sauce-an/tp2_pm/Hardware/Diagrams/TP2-seminar LCD FSM.drawio.png

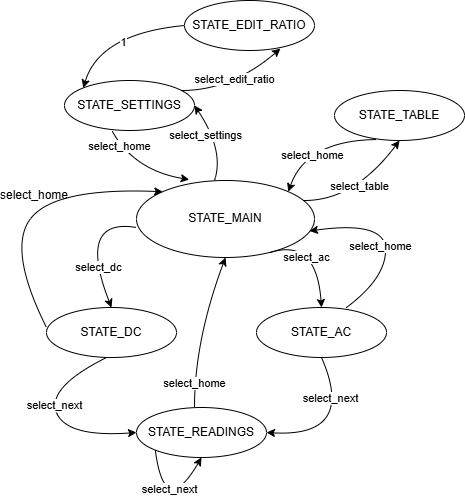
Hardware/Diagrams/TP2-seminar LCD FSM.drawio.png
