sauce-an/tp2_pm/Hardware/Schematics/ENGG3800 schemetic for seminar.pdf

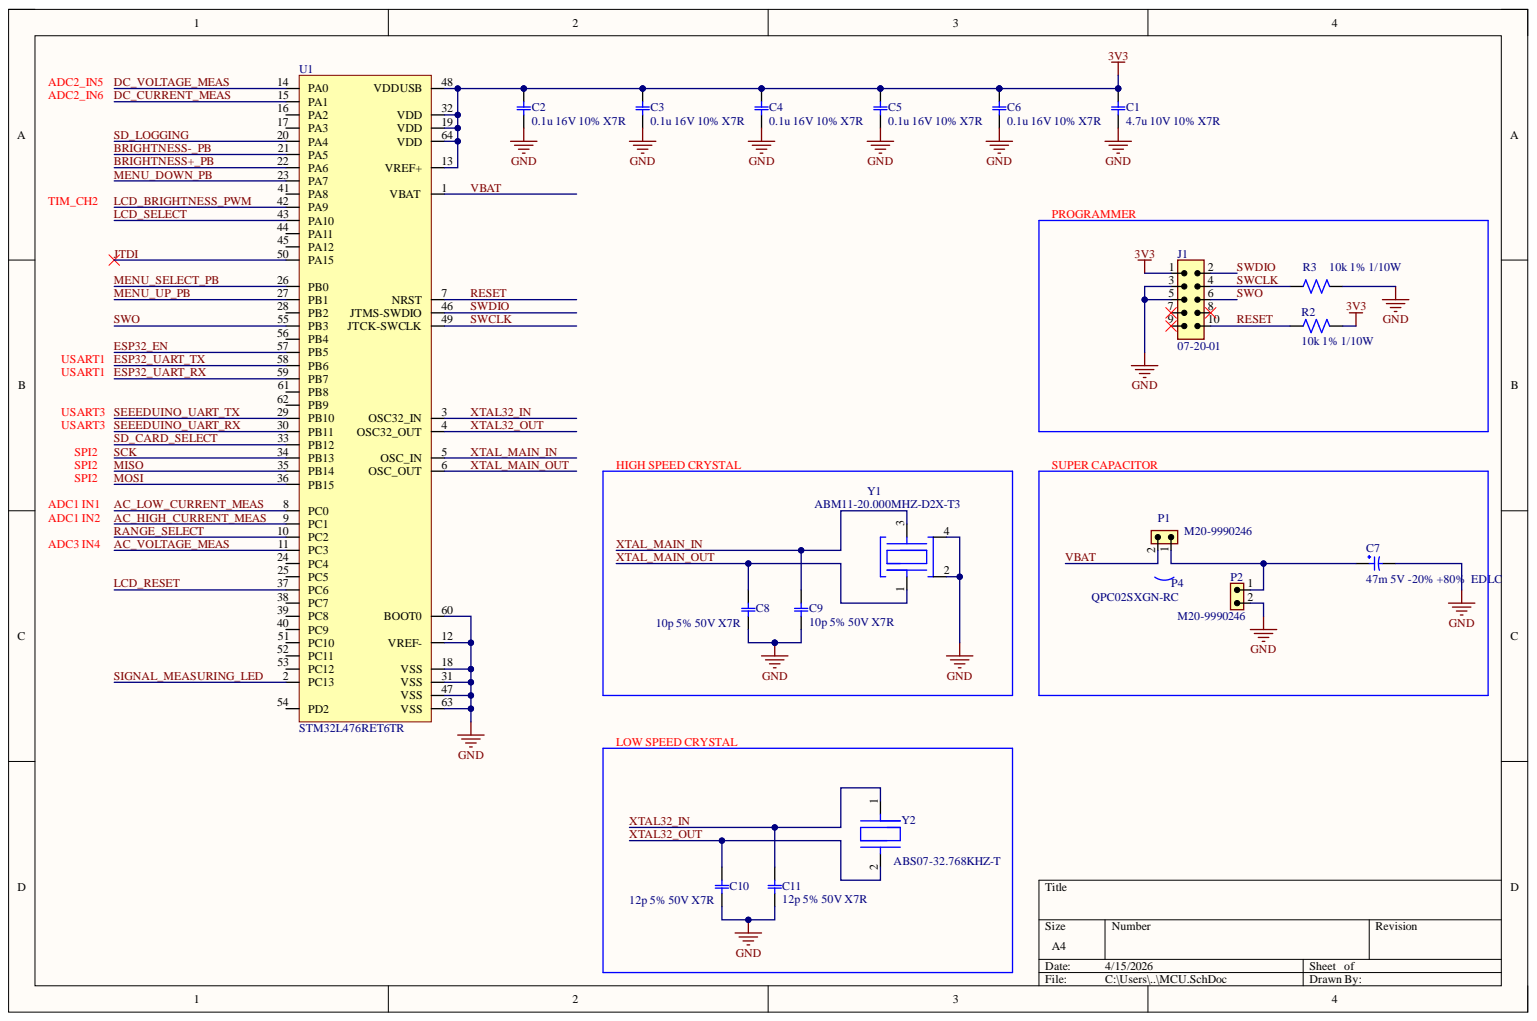
[picture p2: page 1]

1 9
6 4

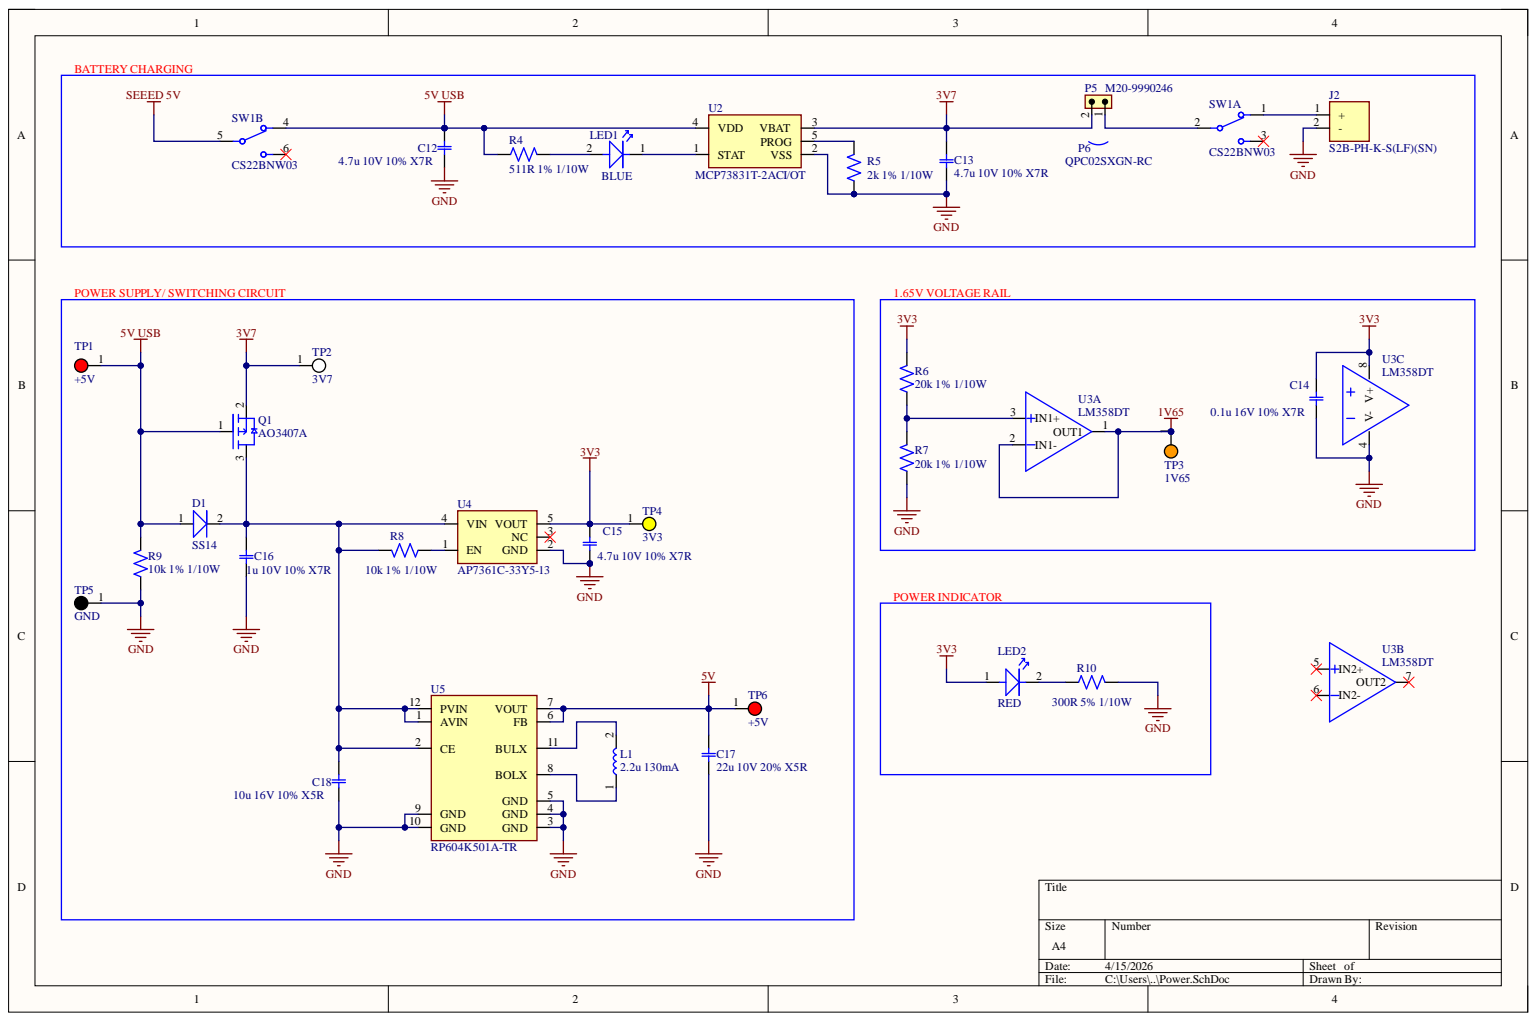
[picture p3: page 2]

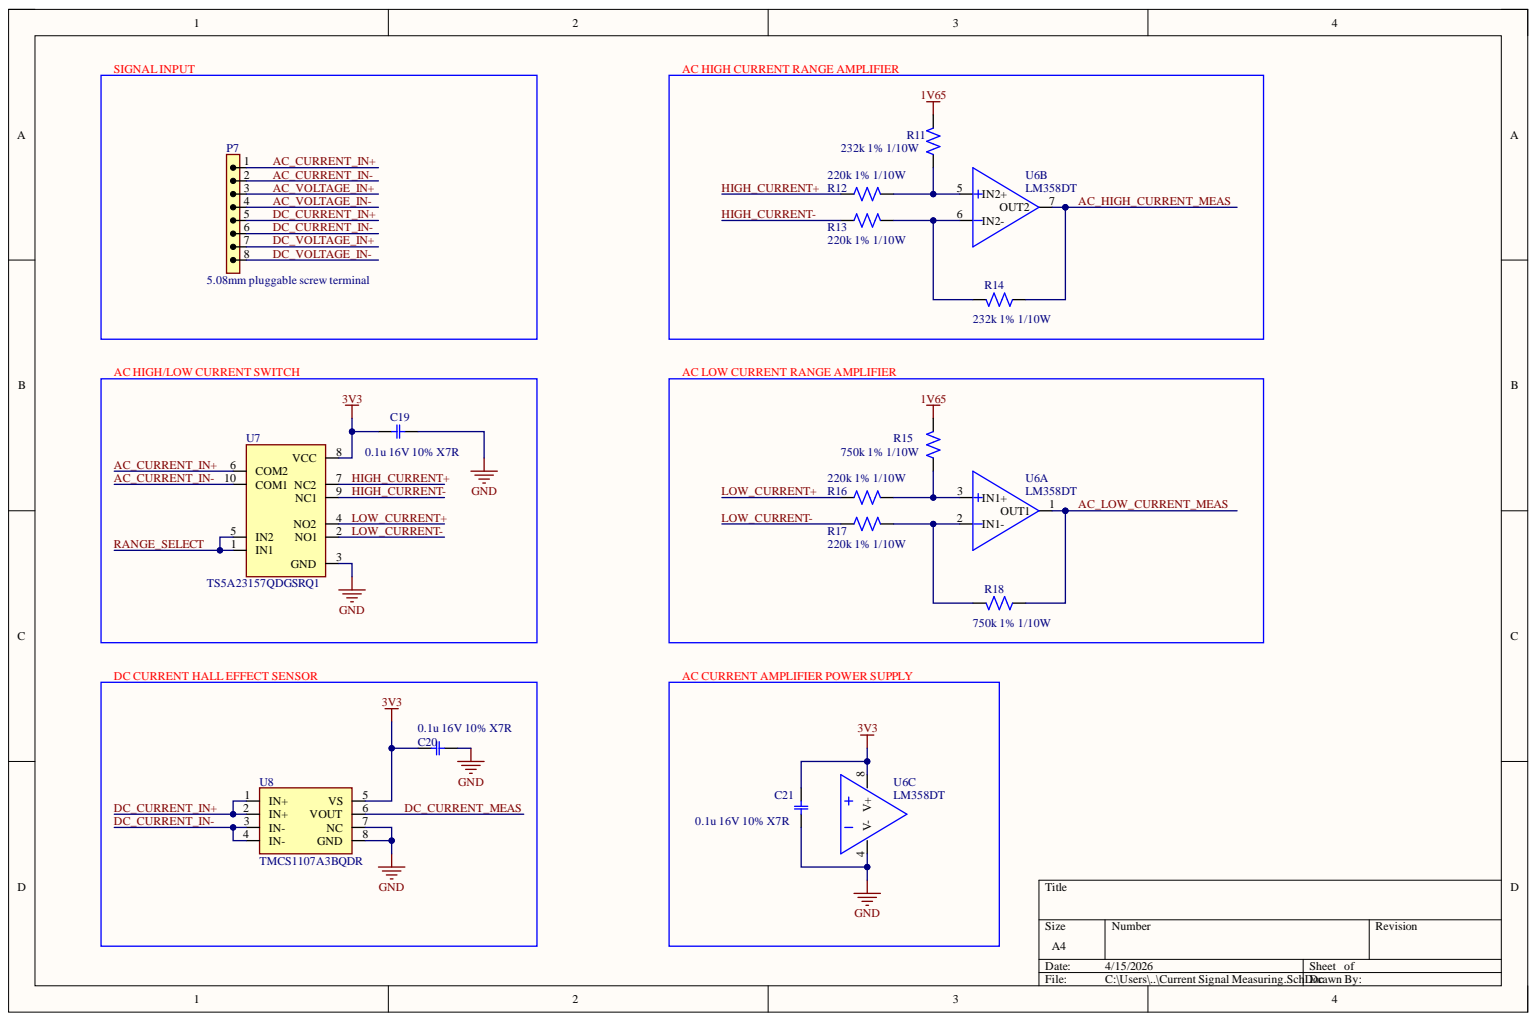
[picture p4: page 3]

AC HIGH CURRENT RANGE AMPLIFIER

AC HIGH/LOW CURRENT SWITCH

AC LOW CURRENT RANGE AMPLIFIER

DC CURRENT HALL EFFECT SENSOR

AC CURRENT AMPLIFIER POWER SUPPLY

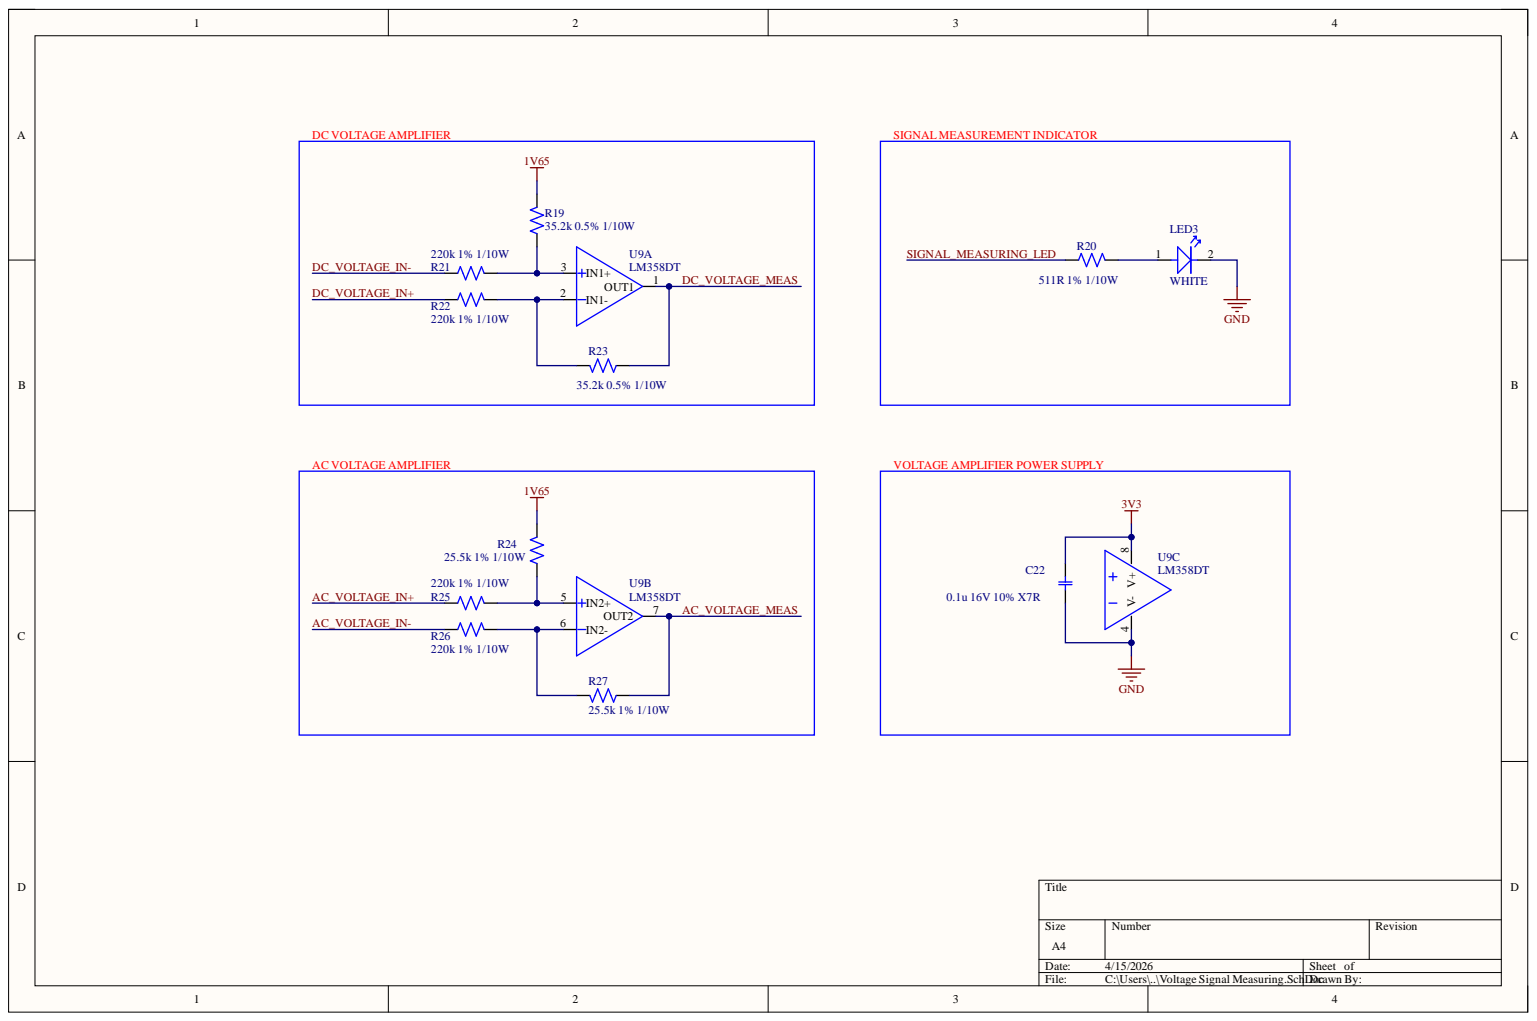
[picture p5: page 4]

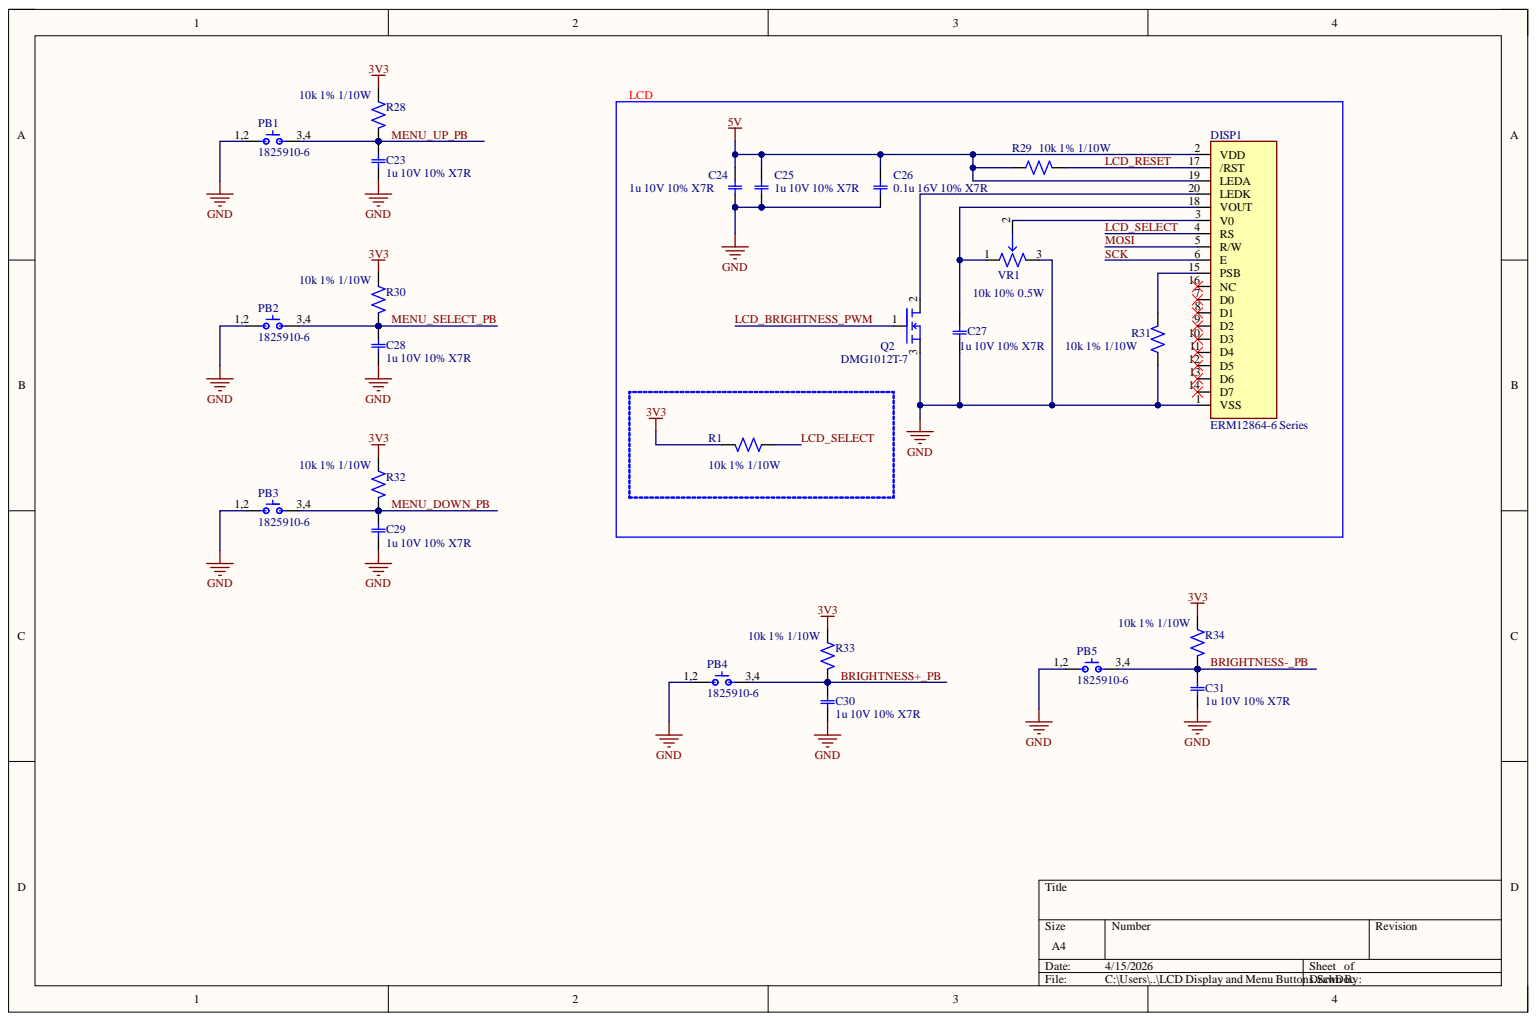
[picture p6: page 5]

1 u 1 0 V 1 0 % X 7 R | 0.1 u 1 6 V 1 0 % X | _RESE T 1 7

LCD _SE L E C T 4 3

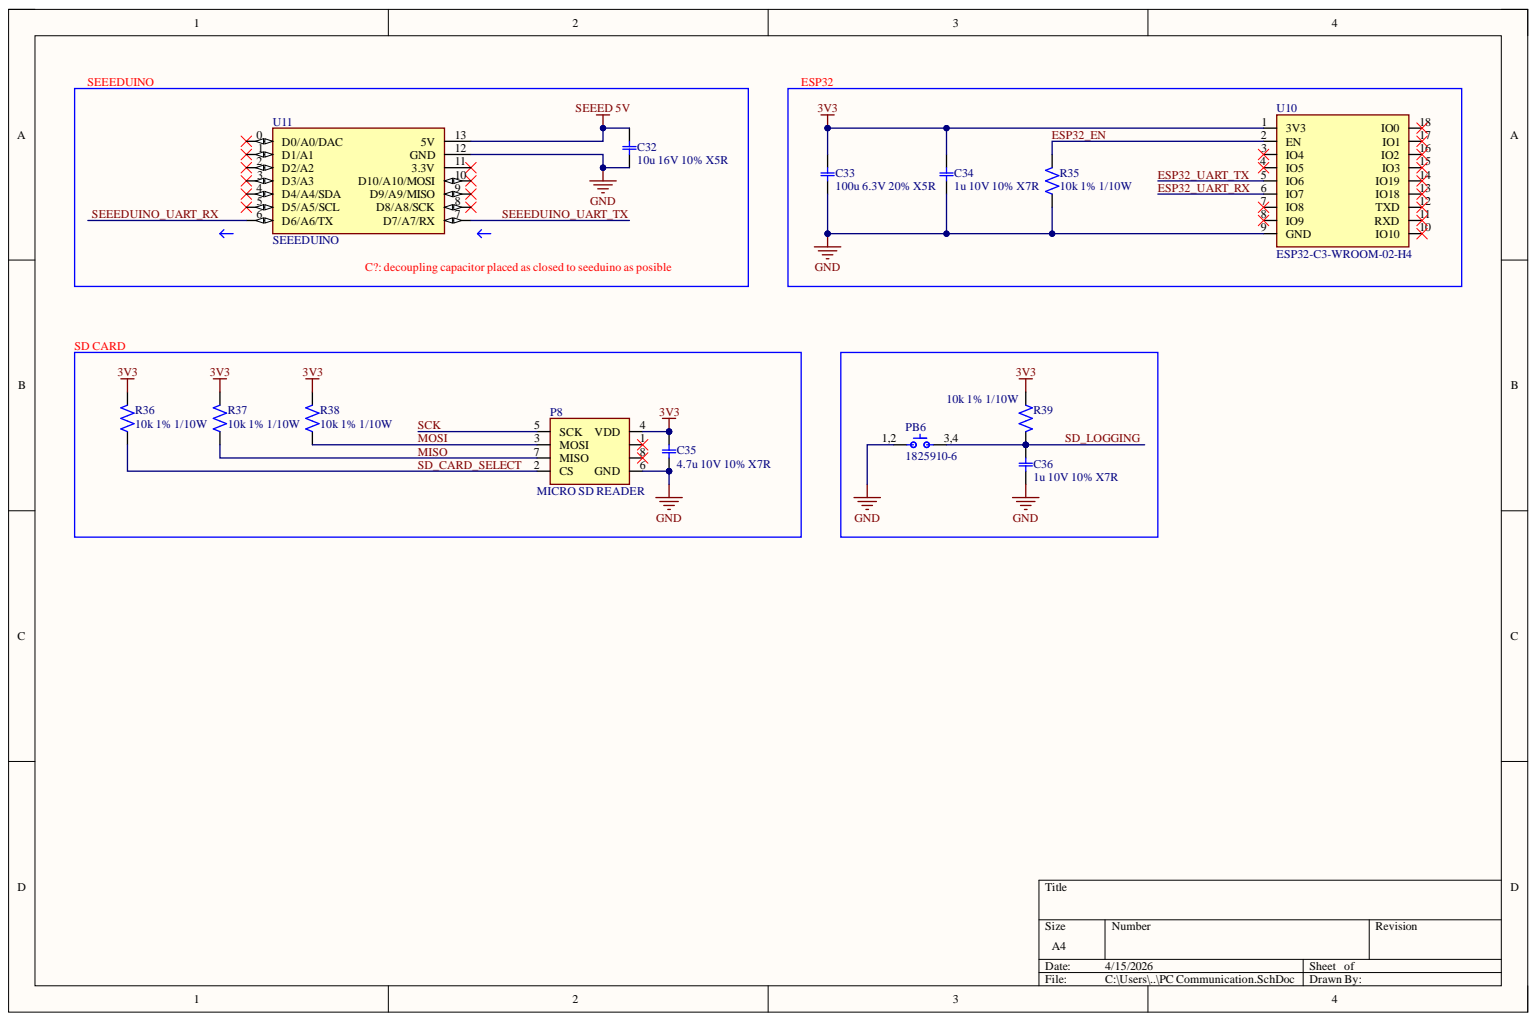
[picture p7: page 6]

C?: decoupling capacitor placed as closed to seeduino as posible

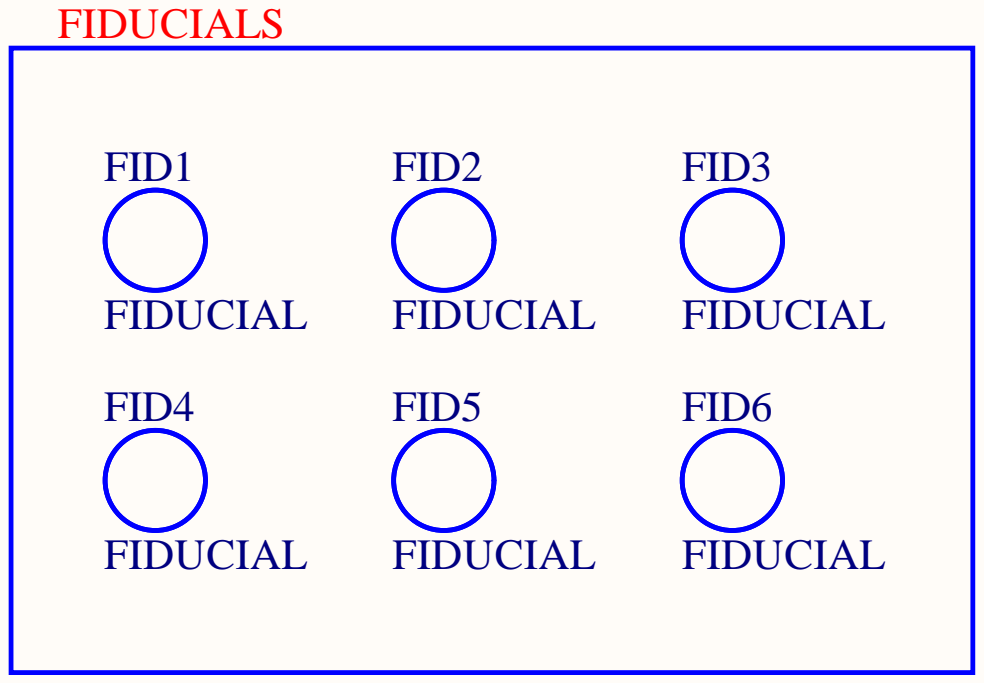
[picture p8: page 7]

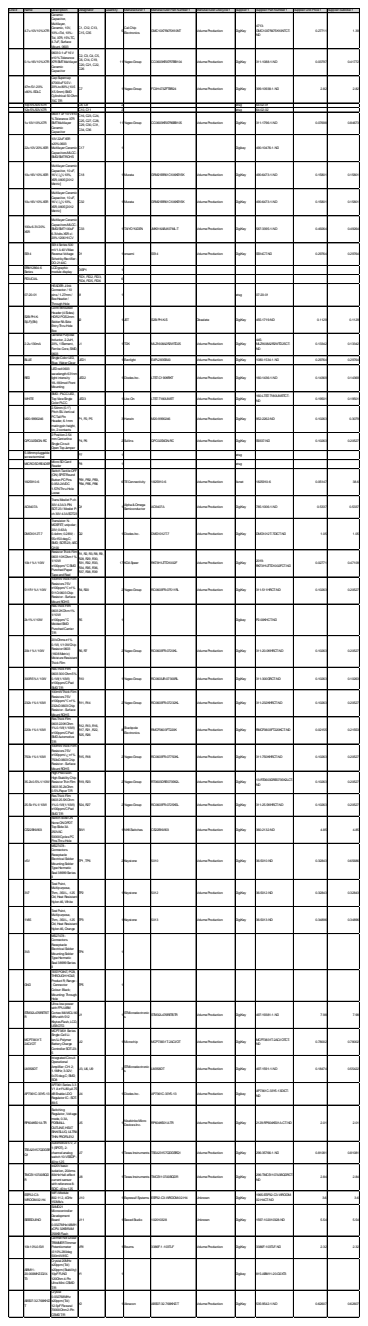
[picture p9: page 8]

0.1u16V10%X7R | 06030.1uF16V ±10%Tolerance X7RSMTMultilayer Ceramic Capacitor | C2, C3, C4, C5, C6, C14, C19, C20, C21, C22, C26 | 11 YageoGroup | CC0603KRX7R7BB104 | VolumeProduction | DigiKey | 311-1088-1-ND | 0.03797 | 0.41772

47m5V-20% +80% EDLC | CapSupercap 47000uF5.5V-20%to80%(10.5 X5.5mm) SMD Cylindrical 50Ohm 70CT/R | C7 | 1 YageoGroup | FC0H473ZFTBR24 | VolumeProduction | DigiKey | 399-10938-1-ND | 2.82 | 2.82

12p5%50VX7R 10p5%50VX7R 1u10V10%X7R | 06031uF10V±10 %ToleranceX7R SMTMultilayer Ceramic Capacitor | C10, C11 C8, C9 C16, C23, C24, C25, C27, C28, C29, C30, C31, C34, C36 | 2 2 11 YageoGroup | CC0603KRX7R6BB105 | VolumeProduction | etsg etsg DigiKey | 64-02-02 64-02-01 311-1796-1-ND | 0.07698 | 0.84673

22u10V20%X5R | 10V22uFX5R ±20%0603 Multilayer Ceramic CapacitorsMLCC-SMD/SMTROHS | C17 | 1 | | | Digikey | 490-10476-1-ND

10u16V10%X5R | Multilayer Ceramic Capacitor, 10uF, 16V, ï¿½10%, X5R, 0805[2012 Metric] | C18 | 1 Murata | GRM21BR61C106KE15K | VolumeProduction | DigiKey | 490-6473-1-ND | 0.15801 | 0.15801

10u16V10%X5R | Multilayer Ceramic Capacitor, 10uF, 16V, ï¿½10%, X5R, 0805[2012 Metric] | C32 | 1 Murata | GRM21BR61C106KE15K | VolumeProduction | DigiKey | 490-6473-1-ND | 0.15801 | 0.15801

100u6.3V20% X5R | Multilayer Ceramic CapacitorsMLCC-SMD/SMT100uF 6.3VoltsX5R+/-20%1206HICV | C33 | 1 TAIYOYUDEN | JMK316ABJ107ML-T | VolumeProduction | DigiKey | 587-3395-1-ND | 0.49264 | 0.49264

SS14 | SS14Series500 mV1A40VMax ReverseVoltage SchottkyRectifier -DO-214AC | D1 | 1 onsemi | SS14 | VolumeProduction | DigiKey | SS14CT-ND | 0.29764 | 0.29764

ERM12864-6 Series | LCDgraphic module display | DISP1 | 1

FIDUCIAL | | FID1, FID2, FID3, FID4, FID5, FID6 | 6

07-20-01 | HEADER: J-link Connector / 10 pins / 1.27mm/ BoxHeader / ThroughHole | J1 | 1 | | | etsg | 07-20-01

S2B-PH-K-S(LF)(SN) | ConnShrouded Header (4Sides) HDR2POS2mm Solder RASide EntryThru-Hole Box | J2 | 1 JST | S2B-PH-K-S | Obsolete | DigiKey | 455-1719-ND | 0.1129 | 0.1129

2.2u130mA | General Purpose Inductor, 2.2uH, 20%, 1Element, Ferrite-Core, SMD, 0603 | L1 | 1 TDK | MLZ1608A2R2WTD25 | VolumeProduction | DigiKey | 445-MLZ1608A2R2WTD25CT-ND | 0.13342 | 0.13342

BLUE | Single Color LED, Blue, Water Clear | LED1 | 1 Everlight | EAPL2835BA3 | VolumeProduction | DigiKey | 1080-1534-1-ND | 0.29764 | 0.29764

RED | LEDred0603 wavelength631nm light intensity 18~180mcd Front Mounting | LED2 | 1 Diodes Inc. | LTST-C190KRKT | VolumeProduction | DigiKey | 160-1436-1-ND | 0.14369 | 0.14369

WHITE | SMD- PLCCLED, TopViewSingle Color PLCC | LED3 | 1 Lite-On | LTST-T180UWET | VolumeProduction | DigiKey | 160-LTST-T180UWETCT-ND | 0.19501 | 0.19501

M20-9990246 | 2.54mm(0.1") PitchSILVertical PCTail Pin Header, 6.1mm matingpin height, tin, 2contacts | P1, P2, P5 | 3 Harwin | M20-9990246 | VolumeProduction | DigiKey | 952-2262-ND | 0.10263 | 0.3079

QPC02SXGN-RC | 2Position2.54 mmCenterline Single Circuit OpenTopJumper | P4, P6 | 2 Sullins | QPC02SXGN-RC | VolumeProduction | DigiKey | S9337-ND | 0.10263 | 0.20527

5.08mmpluggable screwterminal | | P7 | 1 | | | etsg

MICROSDREADER MicroSDCard | Reader | P8 | 1 | | | etsg

1825910-6 | Switch Tactile OFF (ON) SPSTRound ButtonPCPins 0.05A24VDC 1.57NThru-Hole Loose | PB1, PB2, PB3, PB4, PB5, PB6 | 6 TEConnectivity | 1825910-6 | VolumeProduction | Avnet | 1825910-6 | 0.05147 | 38.6

AO3407A | TransMosfet P-ch 30V4.3A3-PIN SOT-23/ Mosfet P-ch 30V4.3ASOT23 | Q1 | 1 Alpha&Omega Semiconductor | AO3407A | VolumeProduction | DigiKey | 785-1006-1-ND | 0.5337 | 0.5337

DMG1012T-7 | Transistor: N-MOSFET; unipolar; 20V; 0.63A; 0.4ohm; 0.28W; -55+150deg.C; SMD; SOT523; AEC-Q100 | Q2 | 1 Diodes Inc. | DMG1012T-7 | VolumeProduction | DigiKey | DMG1012T-7DICT-ND | 1.05 | 1.05

10k1%1/10W | Resistor Thick Film 060310KOhm1% 1/10W ±100ppm/°CSMD PunchedPaper TapeandReel | R1, R2, R3, R8, R9, R28, R29, R30, R31, R32, R33, R34, R35, R36, R37, R38, R39 | 17 KOASpeer | RK73H1JTTD1002F | VolumeProduction | DigiKey | 2019-RK73H1JTTD1002FCT-ND | 0.02771 | 0.47109

511R1%1/10W | 100mWThick Film Resistors75V ±100ppm/℃ ±1% 511Ω0603Chip Resistor - Surface Mount ROHS | R4, R20 | 2 YageoGroup | RC0603FR-07511RL | VolumeProduction | DigiKey | 311-511HRCT-ND | 0.10263 | 0.20527

2k1%1/10W | ResThick Film 06032KOhm1% 1/10W ±100ppm/°C MoldedSMD PunchedCarrier T/R | R5 | 1 | | | Digikey | P2.00KHCT-ND

20k1%1/10W | 20kOhms±1% 0.1W, 1/10WChip Resistor 0603 (1608Metric) MoistureResistant Thick Film | R6, R7 | 2 YageoGroup | RC0603FR-0720KL | VolumeProduction | DigiKey | 311-20.0KHRCT-ND | 0.10263 | 0.20527

300R5%1/10W | ResThick Film 0603300Ohm5% 0.1W(1/10W) ±100ppm/CPad SMDT/R | R10 | 1 YageoGroup | RC0603JR-07300RL | VolumeProduction | DigiKey | 311-300GRCT-ND | 0.10263 | 0.10263

232k1%1/10W | 100mWThick Film Resistors75V ±100ppm/℃ ±1% 232kΩ0603Chip Resistor - Surface Mount ROHS | R11, R14 | 2 YageoGroup | RC0603FR-07232KL | VolumeProduction | DigiKey | 311-232KHRCT-ND | 0.10263 | 0.20527

220k1%1/10W | ResThick Film 0603220KOhm 1%0.1W(1/10W) ±100ppm/CPad SMDAutomotive T/R | R12, R13, R16, R17, R21, R22, R25, R26 | 8 Stackpole Electronics | RMCF0603FT220K | VolumeProduction | DigiKey | RMCF0603FT220KCT-ND | 0.02155 | 0.21553

750k1%1/10W | 100mWThick Film Resistors75V ±100ppm/℃ ±1% 750kΩ0603Chip Resistor - Surface Mount ROHS | R15, R18 | 2 YageoGroup | RC0603FR-07750KL | VolumeProduction | DigiKey | 311-750KHRCT-ND | 0.10263 | 0.20527

35.2k0.5%1/10W | HighPrecision-HighStabilityChip Resistor Thin Film 060335.2kOhm 0.5%Paper T/R | R19, R23 | 2 YageoGroup | RT0603DRE0735K2L | VolumeProduction | DigiKey | 13-RT0603DRE0735K2LCT-ND | 0.10263 | 0.20527

25.5k1%1/10W | ResThick Film 060325.5KOhm 1%0.1W(1/10W) ±100ppm/CPad SMDT/R | R24, R27 | 2 YageoGroup | RC0603FR-0725K5L | VolumeProduction | DigiKey | 311-25.5KHRCT-ND | 0.10263 | 0.20527

CS22BNW03 | SwitchSlideON NoneONDPDT TopSlide3A 250VAC 50000CyclesPC PinsThru-Hole | SW1 | 1 NKKSwitches | CS22BNW03 | VolumeProduction | DigiKey | 360-2132-ND | 4.85 | 4.85

+5V | MS27478-Connectors Receptacle Electrical Solder MountingSolder TypeHermetic Seal 38999Series II | TP1, TP6 | 2 Keystone | 5010 | VolumeProduction | DigiKey | 36-5010-ND | 0.32843 | 0.65686

3V7 | Test Point, Multipurpose, Thm, .350L, .125 Od, Heat Resistant Nylon46, White | TP2 | 1 Keystone | 5012 | VolumeProduction | DigiKey | 36-5012-ND | 0.32843 | 0.32843

1V65 | Test Point, Multipurpose, Thm, .350L, .125 Od, Heat Resistant Nylon46, Orange | TP3 | 1 Keystone | 5013 | VolumeProduction | DigiKey | 36-5013-ND | 0.34896 | 0.34896

3V3 | MS27478-Connectors Receptacle Electrical Solder MountingSolder TypeHermetic Seal 38999Series II | TP4 | 1

GND | TESTPOINT, PCB, THROUGHHOLE; Product R; Range: -; Connector Colour: Black; Mounting: Through Hole | TP5 | 1

STM32L476RET6T R | Ultra-low-power withFPUARM Cortex-M4MCU80 MHzwith512 KbytesFlash, LCD, USBOTG | U1 | 1 STMicroelectronic s | STM32L476RET6TR | VolumeProduction | DigiKey | 497-19381-1-ND | 7.98 | 7.98

MCP73831T-2ACI/OT | MCP73831Series Single-Cell Li-Ion/Li-Polymer BatteryCharge Controller SOT-23-5 | U2 | 1 Microchip | MCP73831T-2ACI/OT | VolumeProduction | DigiKey | MCP73831T-2ACI/OTCT-ND | 0.78002 | 0.78002

LM358DT | IntegratedCircuit Operational Amplifier; CH: 2; 1.1MHz; 3-32V; 0+70deg.C; SMD; SO8 | U3, U6, U9 | 3 STMicroelectronic s | LM358DT | VolumeProduction | DigiKey | 497-1591-1-ND | 0.18474 | 0.55422

AP7361C-33Y5-13 | AP7361Series3.3 V1A±1%80µA75 dBEnable LDO Regulator IC- SOT-89-5 | U4 | 1 Diodes Inc. | AP7361C-33Y5-13 | VolumeProduction | Digikey | AP7361C-33Y5-13DICT-ND

RP604K501A-TR | Switching Regulator, Voltage-mode, 0.3A, PDSMALL OUTLINE, HEAT SINK/SLUG, ULTRA THINPROFILE12 | U5 | 1 NisshinboMicro Devices Inc. | RP604K501A-TR | VolumeProduction | DigiKey | 2129-RP604K501A-CT-ND | 2.01 | 2.01

TS5A23157QDGSR Q1 | Automotive5-V, 2: 1(SPDT), 2-channel analog switch 10-VSSOP-40to125 | U7 | 1 Texas Instruments | TS5A23157QDGSRQ1 | VolumeProduction | DigiKey | 296-35766-1-ND | 0.81081 | 0.81081

TMCS1107A3BQD R | ±420Vbasic isolation, 20Arms 80kHzHall-effect current sensor withreference 8-SOIC-40to125 | U8 | 1 Texas Instruments | TMCS1107A3BQDR | VolumeProduction | DigiKey | 296-TMCS1107A3BQDRCT-ND | 2.84 | 2.84

ESP32-C3-WROOM-02-H4 | WiFi-Module 802.112, 4GHz 150Mb/s | U10 | 1 Espressif Systems | ESP32-C3-WROOM-02-H4 | Unknown | DigiKey | 1965-ESP32-C3-WROOM-02-H4CT-ND | 3.6 | | 3.6

SEEEDUINO | SAMD21 Microcontroller Development Board 0.0327MHz/48MH zCPU32KBRAM 256KBFlash | U11 | 1 SeeedStudio | 102010328 | Unknown | DigiKey | 1597-102010328-ND | 5.54 | 5.54

10k10%0.5W | Cermet Not Linear TRIMMERTrimmer Potentiometer 卤10%280deg 500mW85C | VR1 | 1 Bourns | 3386F-1-103TLF | VolumeProduction | DigiKey | 3386F-103TLF-ND | 2.32 | 2.32

ABM11-20.000MHZ-D2X-T3 | Crystal 20MHz ±20ppm(Tol) ±20ppm(Stability) 10pFFUND 120Ohm4-Pin UltraMini-CSMD T/R | Y1 | 1 | | | Digikey | 815-ABM11-20-D2XT3

ABS07-32.768KHZ-T | Crystal 0.032768MHz ±20ppm(Tol) 12.5pFFlexural 70000Ohm2-Pin CSMDT/R | Y2 | 1 Abracon | ABS07-32.768KHZ-T | VolumeProduction | DigiKey | 535-9542-1-ND | 0.62607 | 0.62607
