sauce-an/tp2_pm/Hardware/Schematics/ENGG3800_PCB_V2_schemetic.pdf

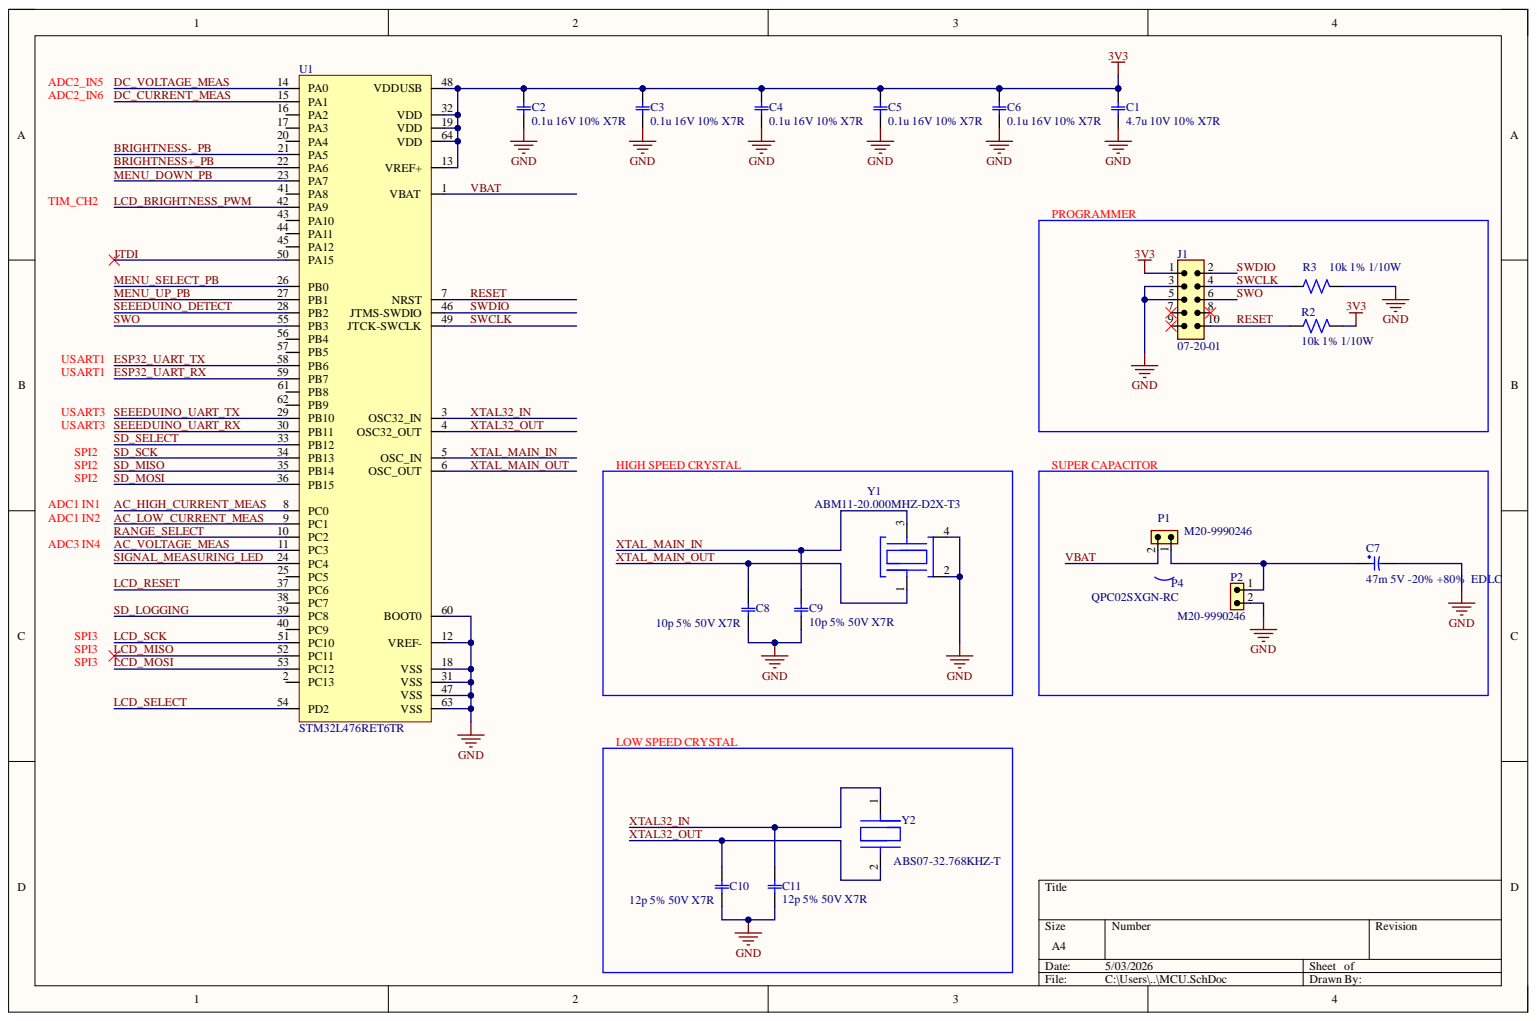
[picture p10: page 1]

1 9
6 4

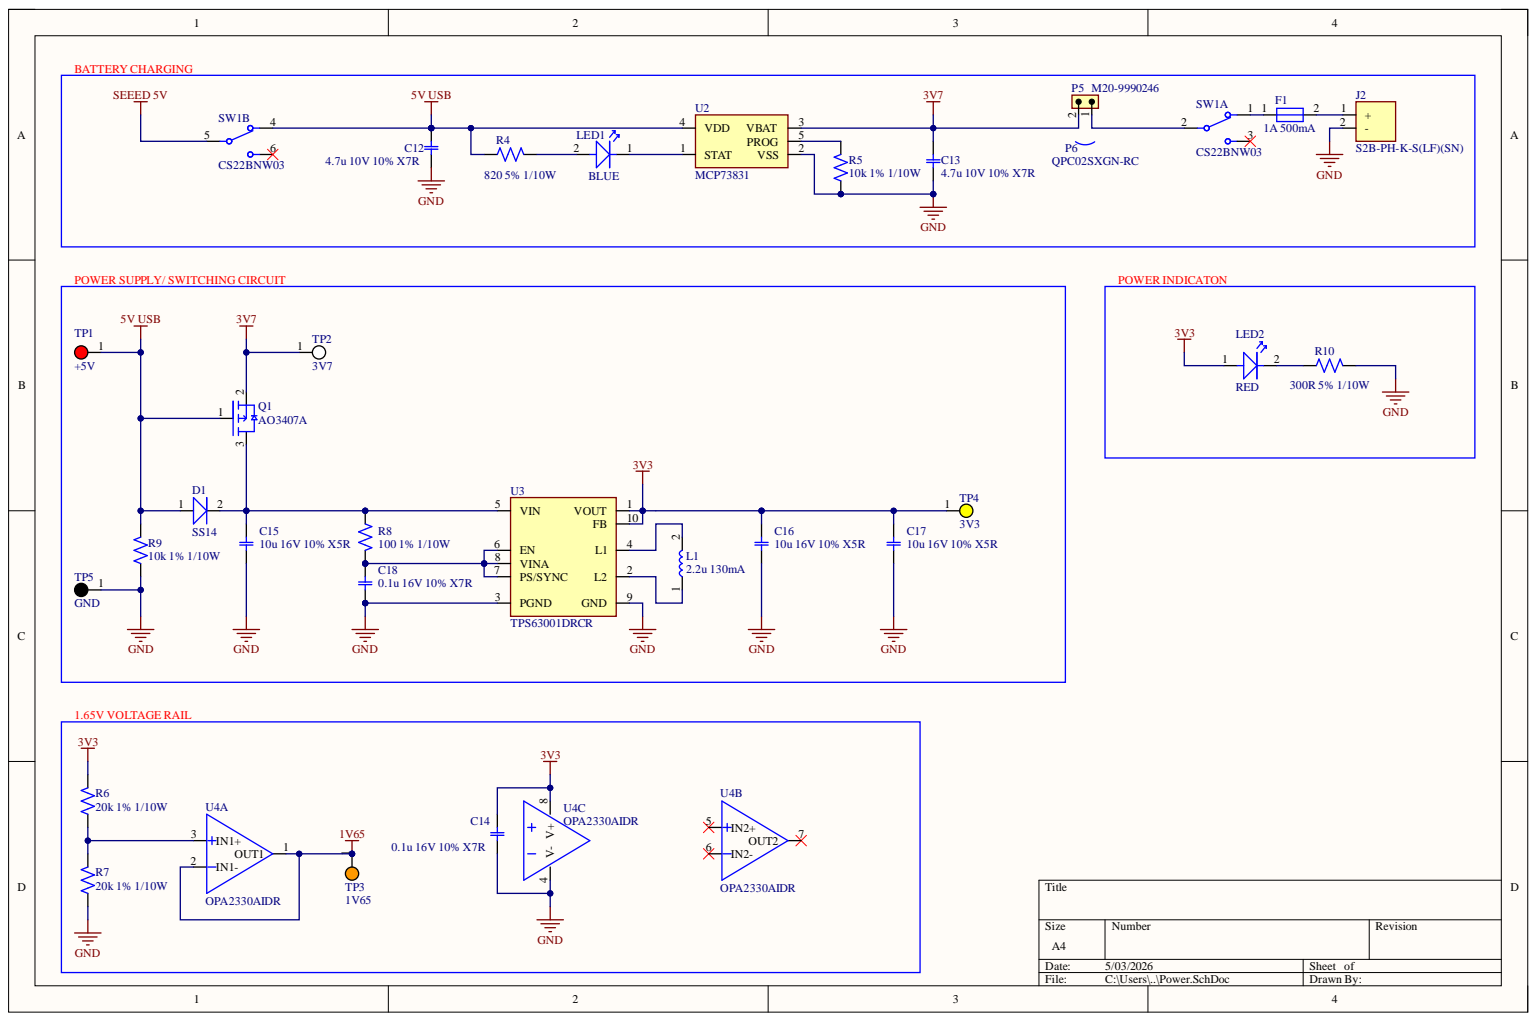
[picture p11: page 2]

POWER SUPPLY/ SWITCHING CIRCUIT

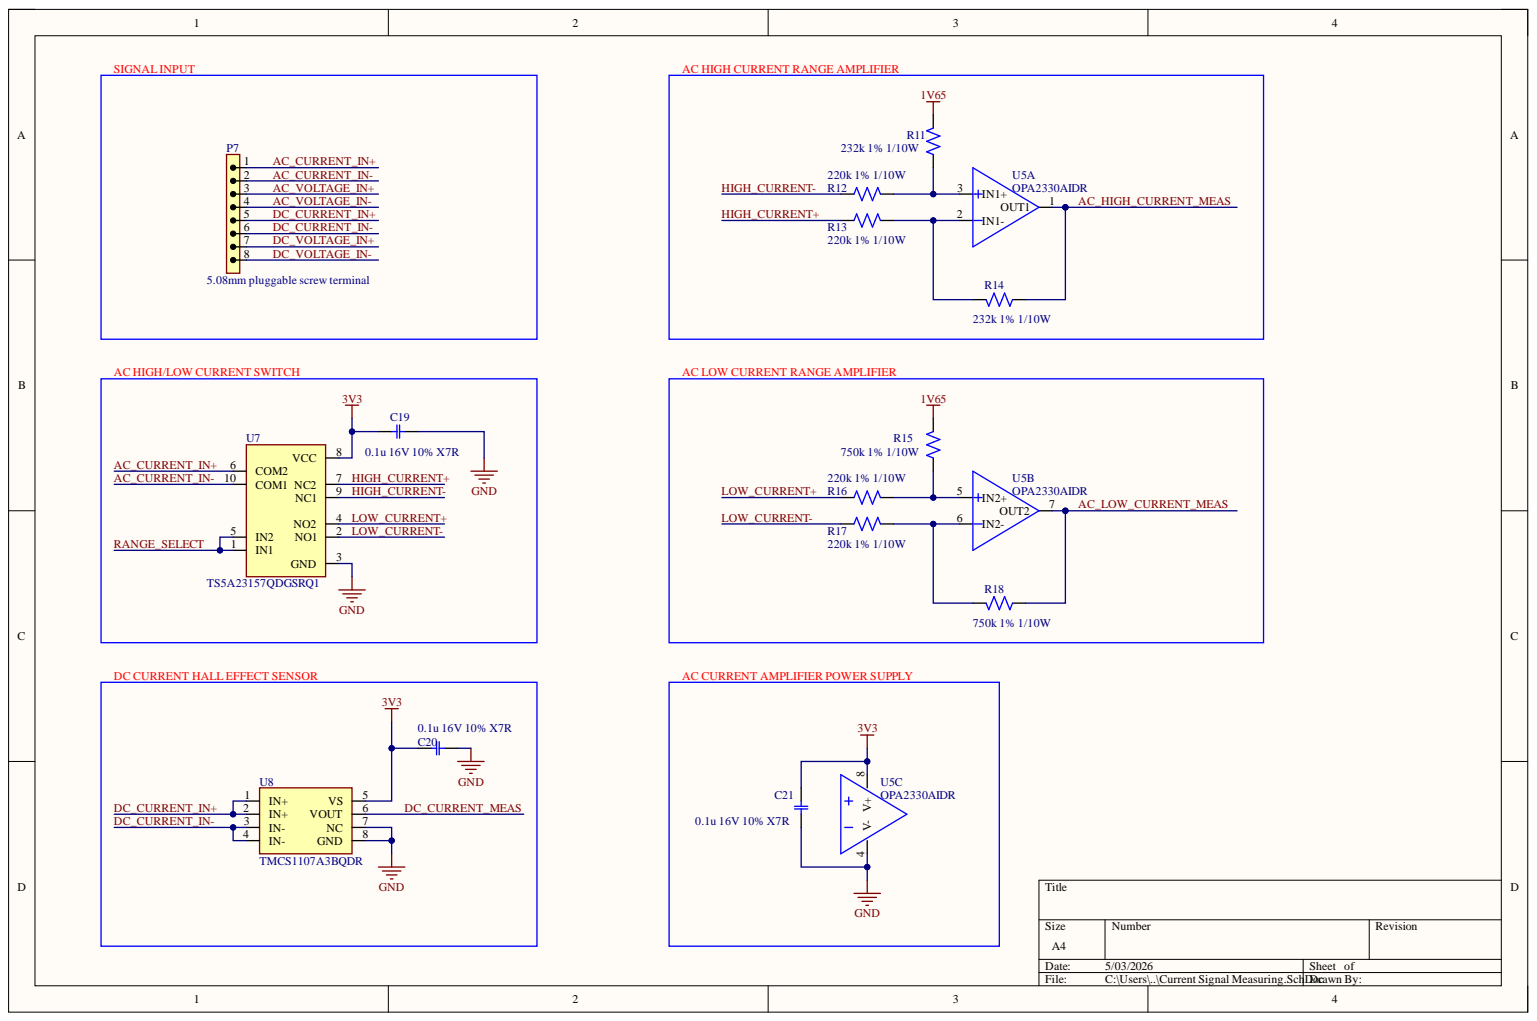
[picture p12: page 3]

AC HIGH CURRENT RANGE AMPLIFIER

AC HIGH/LOW CURRENT SWITCH

AC LOW CURRENT RANGE AMPLIFIER

DC CURRENT HALL EFFECT SENSOR

AC CURRENT AMPLIFIER POWER SUPPLY

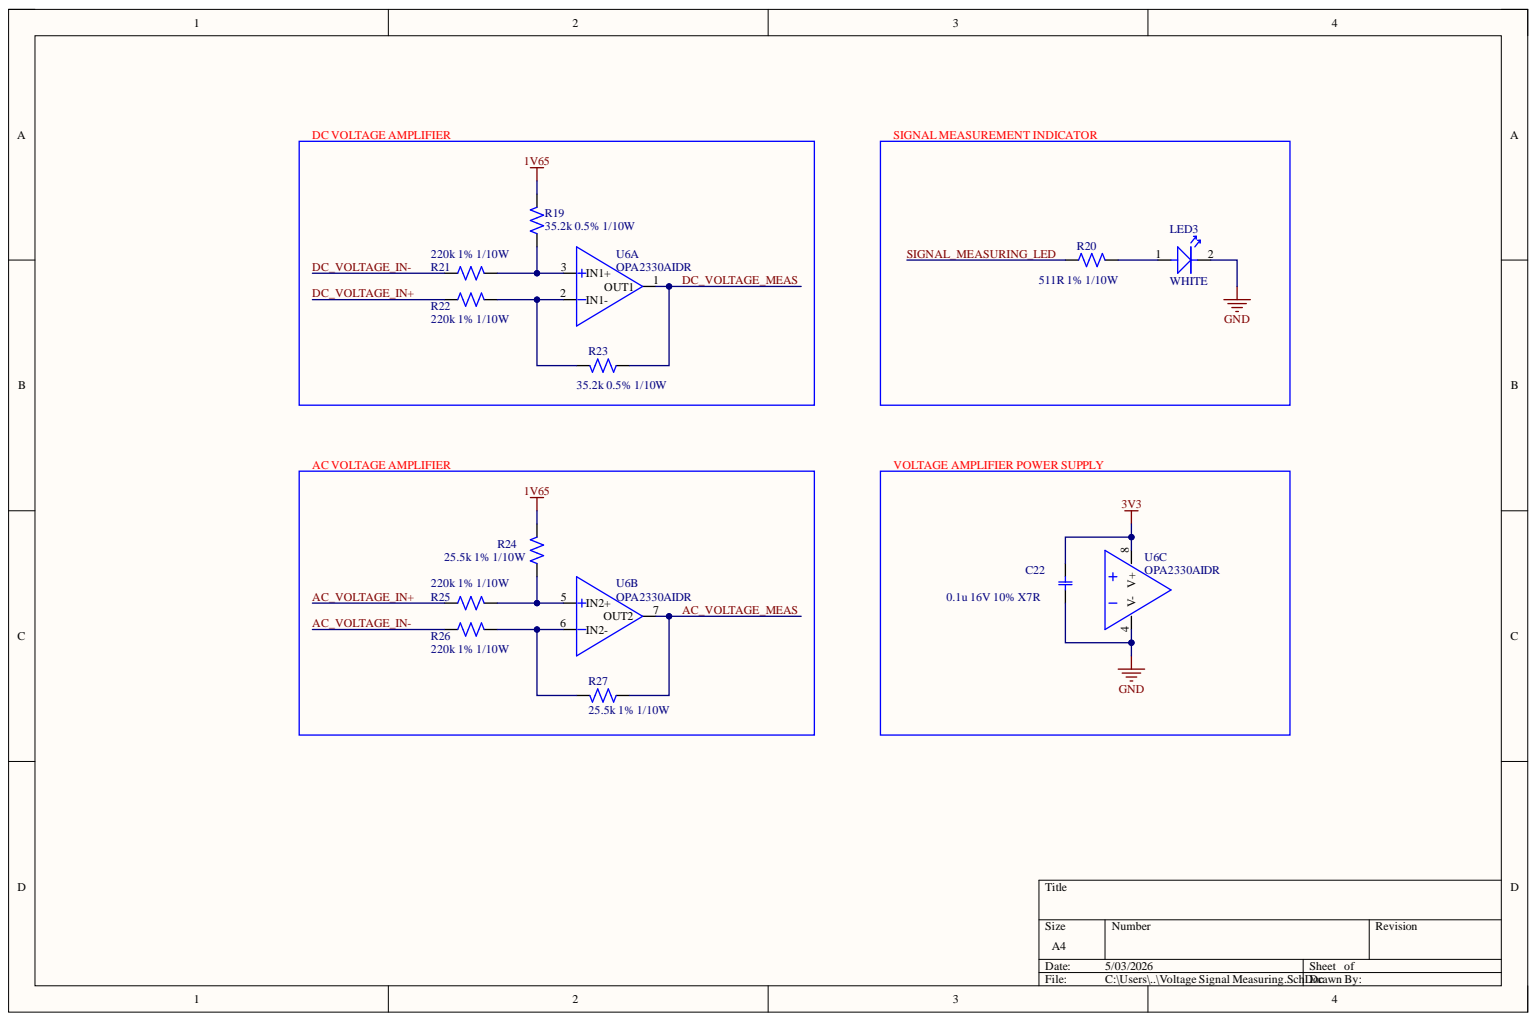
[picture p13: page 4]

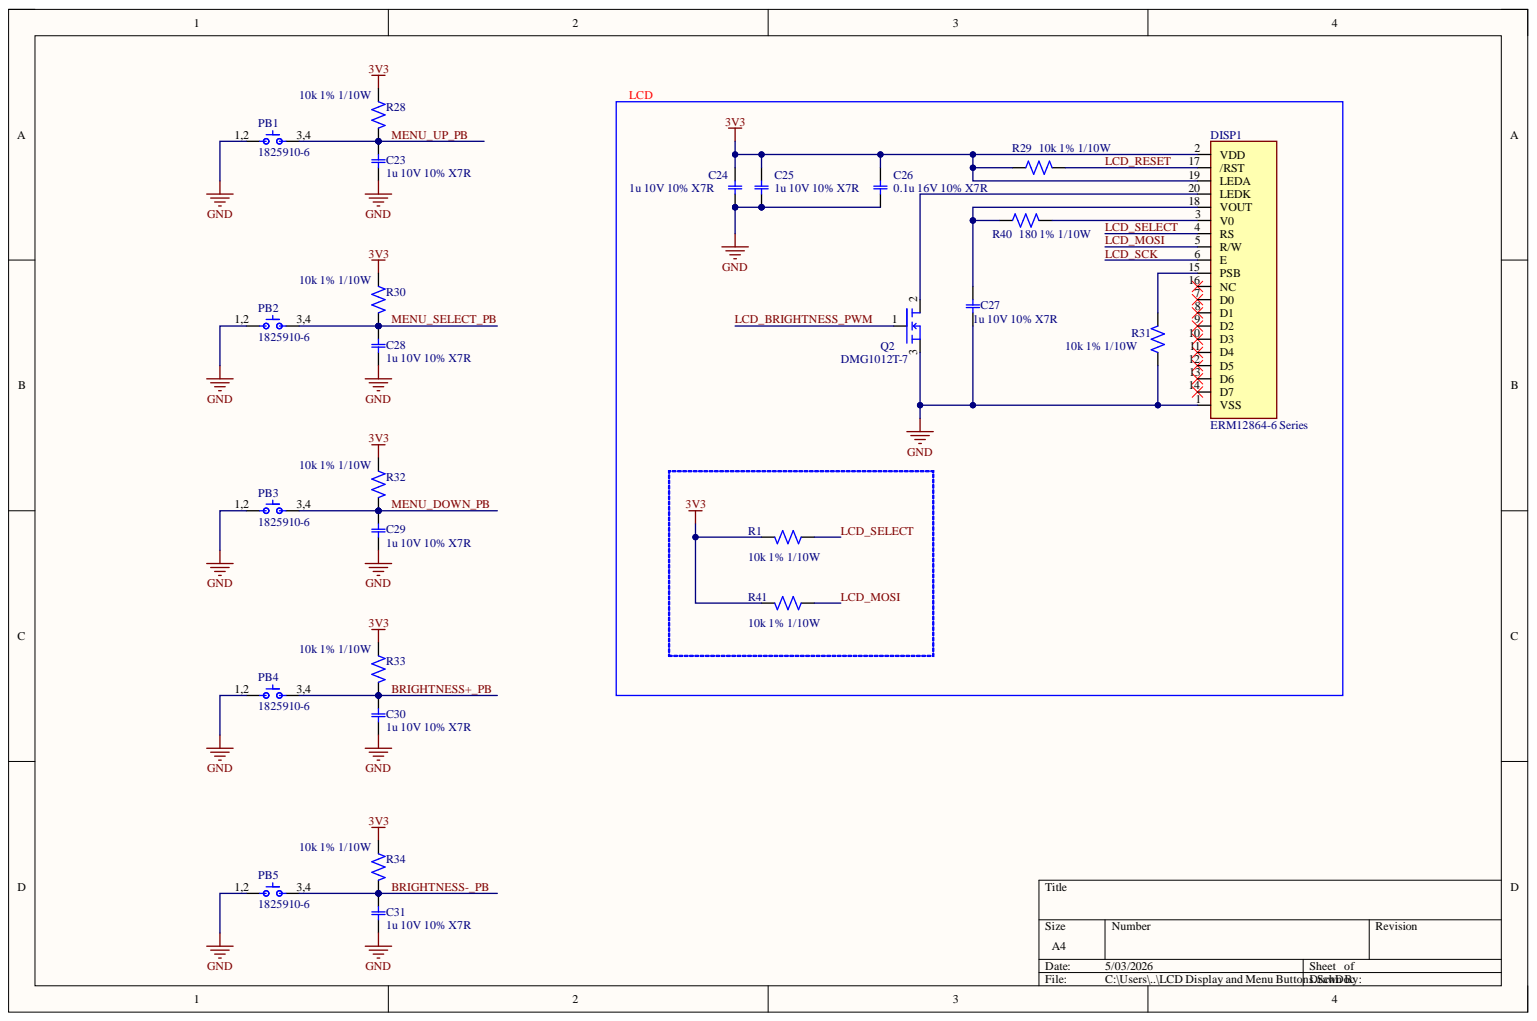
[picture p14: page 5]

1 u 1 0 V 1 0 % X 7 R | 0.1 u 1 6 V 1 0 % X | _RESE T 1 7

1 8

LCD _SE L E C T 4 R4 0 1 8 0 1 % 1 / 1 0 W

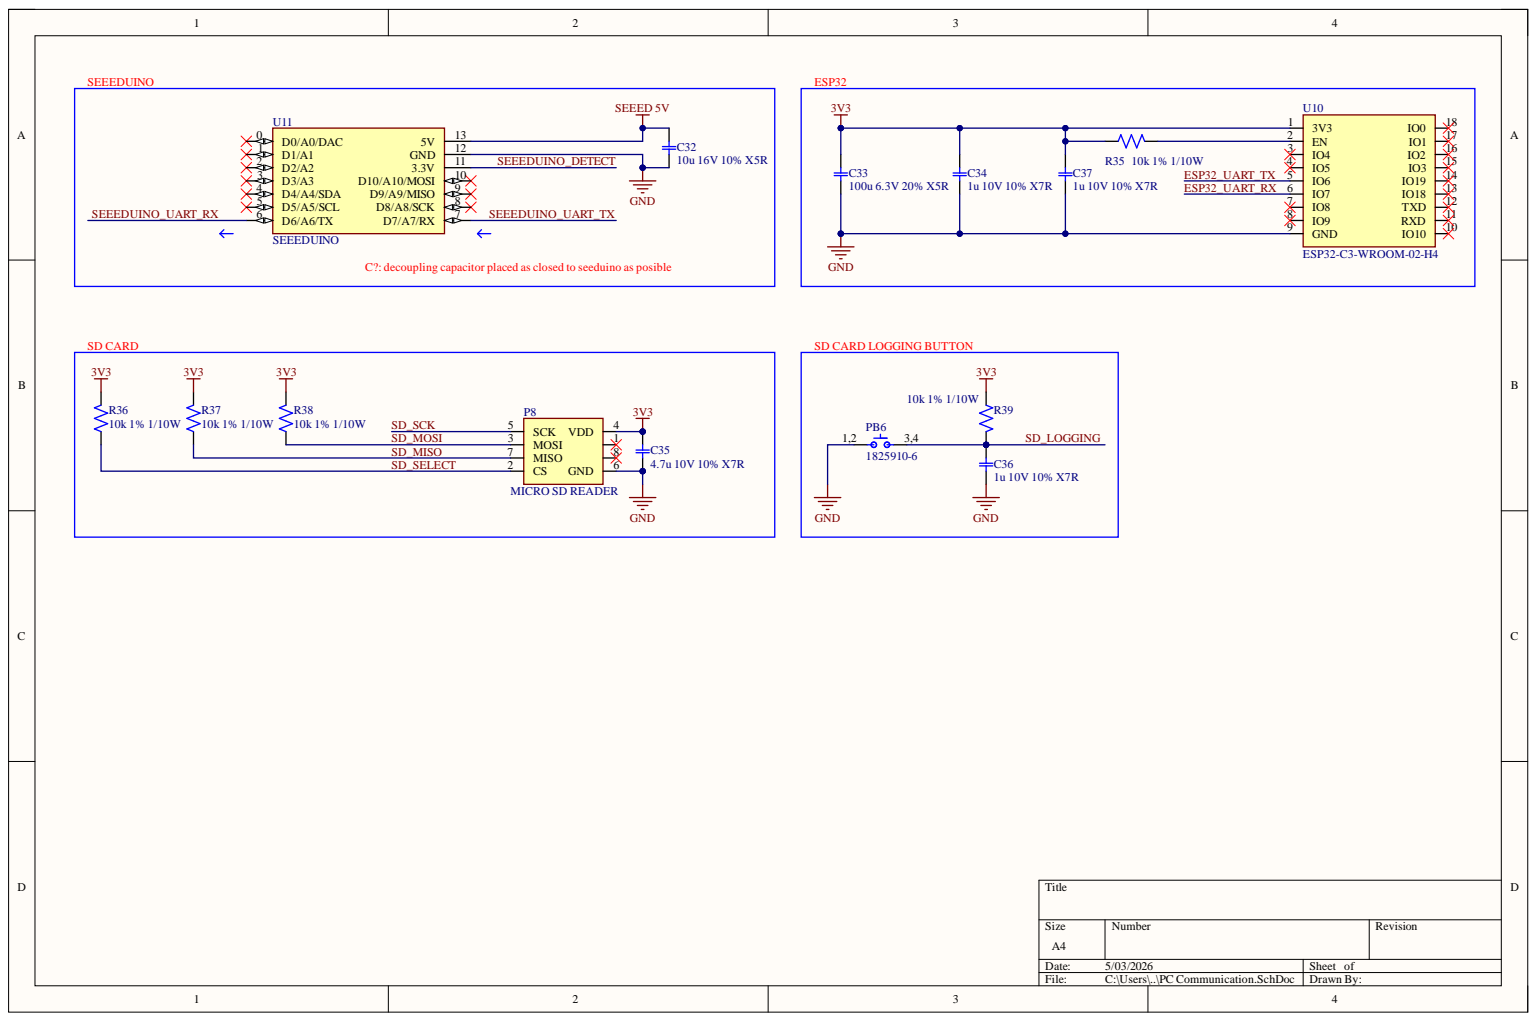
[picture p15: page 6]

C?: decoupling capacitor placed as closed to seeduino as posible

SD CARD LOGGING BUTTON


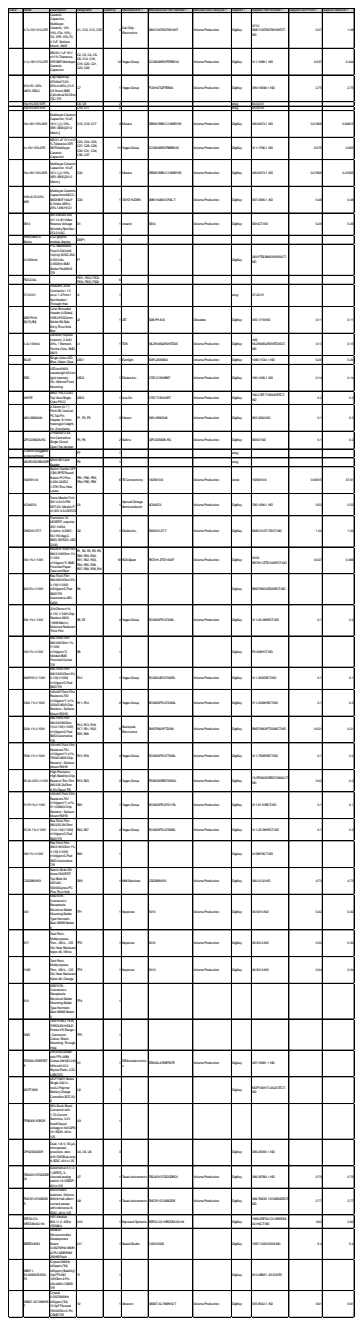
[picture p16: page 8]

0.1u16V10%X7R | 06030.1uF16V ±10%Tolerance X7RSMTMultilayer Ceramic Capacitor | C2, C3, C4, C5, C6, C14, C18, C19, C20, C21, C22, C26 | 12 YageoGroup | CC0603KRX7R7BB104 | VolumeProduction | DigiKey | 311-1088-1-ND | 0.037 | 0.444

47m5V-20% +80% EDLC | CapSupercap 47000uF5.5V-20%to80%(10.5 X5.5mm) SMD Cylindrical 50Ohm 70CT/R | C7 | 1 YageoGroup | FC0H473ZFTBR24 | VolumeProduction | DigiKey | 399-10938-1-ND | 2.75 | 2.75

10p5%50VX7R 12p5%50VX7R 10u16V10%X5R | Multilayer Ceramic Capacitor, 10uF, 16V, ï¿½10%, X5R, 0805[2012 Metric] | C8, C9 C10, C11 C15, C16, C17 | 2 2 3 Murata | GRM21BR61C106KE15K | VolumeProduction | etsg etsg DigiKey | 64-02-01 64-02-02 490-6473-1-ND | 0.21605 | 0.64815

1u10V10%X7R | 06031uF10V±10 %ToleranceX7R SMTMultilayer Ceramic Capacitor | C23, C24, C25, C27, C28, C29, C30, C31, C34, C36, C37 | 11 YageoGroup | CC0603KRX7R6BB105 | VolumeProduction | DigiKey | 311-1796-1-ND | 0.075 | 0.825

10u16V10%X5R | Multilayer Ceramic Capacitor, 10uF, 16V, ï¿½10%, X5R, 0805[2012 Metric] | C32 | 1 Murata | GRM21BR61C106KE15K | VolumeProduction | DigiKey | 490-6473-1-ND | 0.21605 | 0.21605

100u6.3V20% X5R | Multilayer Ceramic CapacitorsMLCC-SMD/SMT100uF 6.3VoltsX5R+/-20%1206HICV | C33 | 1 TAIYOYUDEN | JMK316ABJ107ML-T | VolumeProduction | DigiKey | 587-3395-1-ND | 0.48 | 0.48

SS14 | SS14Series500 mV1A40VMax ReverseVoltage SchottkyRectifier -DO-214AC | D1 | 1 onsemi | SS14 | VolumeProduction | DigiKey | SS14CT-ND | 0.29 | 0.29

ERM12864-6 Series | LCDgraphic module display | DISP1 | 1

1A500mA | PTCResettable Fuse0.5A(hold) 1A(trip) 8VDC25A 0.5W0.6s 0.05OhmSMD Solder Pad0603 T/R | F1 | 1 | | | DigiKey | 283-PTSLR06038V050CT-ND

FIDUCIAL | | FID1, FID2, FID3, FID4, FID5, FID6 | 6

07-20-01 | HEADER: J-link Connector / 10 pins / 1.27mm/ BoxHeader / ThroughHole | J1 | 1 | | | etsg | 07-20-01

S2B-PH-K-S(LF)(SN) | ConnShrouded Header (4Sides) HDR2POS2mm Solder RASide EntryThru-Hole Box | J2 | 1 JST | S2B-PH-K-S | Obsolete | DigiKey | 455-1719-ND | 0.11 | 0.11

2.2u130mA | General Purpose Inductor, 2.2uH, 20%, 1Element, Ferrite-Core, SMD, 0603 | L1 | 1 TDK | MLZ1608A2R2WTD25 | VolumeProduction | DigiKey | 445-MLZ1608A2R2WTD25CT-ND | 0.13 | 0.13

BLUE | Single Color LED, Blue, Water Clear | LED1 | 1 Everlight | EAPL2835BA3 | VolumeProduction | DigiKey | 1080-1534-1-ND | 0.29 | 0.29

RED | LEDred0603 wavelength631nm light intensity 18~180mcd Front Mounting | LED2 | 1 Diodes Inc. | LTST-C190KRKT | VolumeProduction | DigiKey | 160-1436-1-ND | 0.14 | 0.14

WHITE | SMD- PLCCLED, TopViewSingle Color PLCC | LED3 | 1 Lite-On | LTST-T180UWET | VolumeProduction | DigiKey | 160-LTST-T180UWETCT-ND | | 0.2 | 0.2

M20-9990246 | 2.54mm(0.1") PitchSILVertical PCTail Pin Header, 6.1mm matingpin height, tin, 2contacts | P1, P2, P5 | 3 Harwin | M20-9990246 | VolumeProduction | DigiKey | 952-2262-ND | | 0.1 | 0.3

QPC02SXGN-RC | 2Position2.54 mmCenterline Single Circuit OpenTopJumper | P4, P6 | 2 Sullins | QPC02SXGN-RC | VolumeProduction | DigiKey | S9337-ND | | 0.1 | 0.2

5.08mmpluggable screwterminal | | P7 | 1 | | | etsg

MICROSDREADER MicroSDCard | Reader | P8 | 1 | | | etsg

1825910-6 | Switch Tactile OFF (ON) SPSTRound ButtonPCPins 0.05A24VDC 1.57NThru-Hole Loose | PB1, PB2, PB3, PB4, PB5, PB6 | 6 TEConnectivity | 1825910-6 | VolumeProduction | Avnet | 1825910-6 | 0.05015 | 37.61

AO3407A | TransMosfet P-ch 30V4.3A3-PIN SOT-23/ Mosfet P-ch 30V4.3ASOT23 | Q1 | 1 Alpha&Omega Semiconductor | AO3407A | VolumeProduction | DigiKey | 785-1006-1-ND | 0.52 | 0.52

DMG1012T-7 | Transistor: N-MOSFET; unipolar; 20V; 0.63A; 0.4ohm; 0.28W; -55+150deg.C; SMD; SOT523; AEC-Q100 | Q2 | 1 Diodes Inc. | DMG1012T-7 | VolumeProduction | DigiKey | DMG1012T-7DICT-ND | 1.02 | 1.02

10k1%1/10W | Resistor Thick Film 060310KOhm1% 1/10W ±100ppm/°CSMD PunchedPaper TapeandReel | R1, R2, R3, R5, R9, R28, R29, R30, R31, R32, R33, R34, R35, R36, R37, R38, R39, R41 | 18 KOASpeer | RK73H1JTTD1002F | VolumeProduction | DigiKey | 2019-RK73H1JTTD1002FCT-ND | 0.027 | 0.486

8205%1/10W | ResThick Film 0603820Ohm5% 0.1W(1/10W) ±200ppm/CPad SMDT/R AutomotiveAEC-Q200 | R4 | 1 | | | Digikey | RMCF0603JT820RCT-ND

20k1%1/10W | 20kOhms±1% 0.1W, 1/10WChip Resistor 0603 (1608Metric) MoistureResistant Thick Film | R6, R7 | 2 YageoGroup | RC0603FR-0720KL | VolumeProduction | DigiKey | 311-20.0KHRCT-ND | | 0.1 | 0.2

1001%1/10W | ResThick Film 06032KOhm1% 1/10W ±100ppm/°C MoldedSMD PunchedCarrier T/R | R8 | 1 | | | Digikey | P2.00KHCT-ND

300R5%1/10W | ResThick Film 0603300Ohm5% 0.1W(1/10W) ±100ppm/CPad SMDT/R | R10 | 1 YageoGroup | RC0603JR-07300RL | VolumeProduction | DigiKey | 311-300GRCT-ND | | 0.1 | 0.1

232k1%1/10W | 100mWThick Film Resistors75V ±100ppm/℃ ±1% 232kΩ0603Chip Resistor - Surface Mount ROHS | R11, R14 | 2 YageoGroup | RC0603FR-07232KL | VolumeProduction | DigiKey | 311-232KHRCT-ND | | 0.1 | 0.2

220k1%1/10W | ResThick Film 0603220KOhm 1%0.1W(1/10W) ±100ppm/CPad SMDAutomotive T/R | R12, R13, R16, R17, R21, R22, R25, R26 | 8 Stackpole Electronics | RMCF0603FT220K | VolumeProduction | DigiKey | RMCF0603FT220KCT-ND | 0.021 | 0.21

750k1%1/10W | 100mWThick Film Resistors75V ±100ppm/℃ ±1% 750kΩ0603Chip Resistor - Surface Mount ROHS | R15, R18 | 2 YageoGroup | RC0603FR-07750KL | VolumeProduction | DigiKey | 311-750KHRCT-ND | | 0.1 | 0.2

35.2k0.5%1/10W | HighPrecision-HighStabilityChip Resistor Thin Film 060335.2kOhm 0.5%Paper T/R | R19, R23 | 2 YageoGroup | RT0603DRE0735K2L | VolumeProduction | DigiKey | 13-RT0603DRE0735K2LCT-ND | 0.02 | | 0.2

511R1%1/10W | 100mWThick Film Resistors75V ±100ppm/℃ ±1% 511Ω0603Chip Resistor - Surface Mount ROHS | R20 | 1 YageoGroup | RC0603FR-07511RL | VolumeProduction | DigiKey | 311-511HRCT-ND | | 0.1 | 0.1

25.5k1%1/10W | ResThick Film 060325.5KOhm 1%0.1W(1/10W) ±100ppm/CPad SMDT/R | R24, R27 | 2 YageoGroup | RC0603FR-0725K5L | VolumeProduction | DigiKey | 311-25.5KHRCT-ND | | 0.1 | 0.2

1801%1/10W | ResThick Film 0603180Ohm1% 0.1W(1/10W) ±100ppm/CPad SMDAutomotive T/R | R40 | 1 | | | Digikey | A129679CT-ND

CS22BNW03 | SwitchSlideON NoneONDPDT TopSlide3A 250VAC 50000CyclesPC PinsThru-Hole | SW1 | 1 NKKSwitches | CS22BNW03 | VolumeProduction | DigiKey | 360-2132-ND | 4.73 | 4.73

+5V | MS27478-Connectors Receptacle Electrical Solder MountingSolder TypeHermetic Seal 38999Series II | TP1 | 1 Keystone | 5010 | VolumeProduction | DigiKey | 36-5010-ND | 0.32 | 0.32

3V7 | Test Point, Multipurpose, Thm, .350L, .125 Od, Heat Resistant Nylon46, White | TP2 | 1 Keystone | 5012 | VolumeProduction | DigiKey | 36-5012-ND | 0.32 | 0.32

1V65 | Test Point, Multipurpose, Thm, .350L, .125 Od, Heat Resistant Nylon46, Orange | TP3 | 1 Keystone | 5013 | VolumeProduction | DigiKey | 36-5013-ND | 0.34 | 0.34

3V3 | MS27478-Connectors Receptacle Electrical Solder MountingSolder TypeHermetic Seal 38999Series II | TP4 | 1

GND | TESTPOINT, PCB, THROUGHHOLE; Product R; Range: -; Connector Colour: Black; Mounting: Through Hole | TP5 | 1

STM32L476RET6T R | Ultra-low-power withFPUARM Cortex-M4MCU80 MHzwith512 KbytesFlash, LCD, USBOTG | U1 | 1 STMicroelectronic s | STM32L476RET6TR | VolumeProduction | Digikey | 497-19381-1-ND

MCP73831 | MCP73831Series Single-Cell Li-Ion/Li-Polymer BatteryCharge Controller SOT-23-5 | U2 | 1 | | | Digikey | MCP73831T-2ACI/OTCT-ND

TPS63001DRCR | 96%Buck-Boost Converter with 1.7ACurrent Switches, 3.3V fixedOutput voltagein 3x3QFN 10-VSON-40to 125 | U3 | 1

OPA2330AIDR | Dual, 1.8-V, 35-µA, micropower, precision, zero drift CMOSopamp 8-SOIC-40to125 | U4, U5, U6 | 3 | | | Digikey | 296-25305-1-ND

TS5A23157QDGSR Q1 | Automotive5-V, 2: 1(SPDT), 2-channel analog switch 10-VSSOP-40to125 | U7 | 1 Texas Instruments | TS5A23157QDGSRQ1 | VolumeProduction | DigiKey | 296-35766-1-ND | 0.79 | 0.79

TMCS1107A3BQD R | ±420Vbasic isolation, 20Arms 80kHzHall-effect current sensor withreference 8-SOIC-40to125 | U8 | 1 Texas Instruments | TMCS1107A3BQDR | VolumeProduction | DigiKey | 296-TMCS1107A3BQDRCT-ND | 2.77 | 2.77

ESP32-C3-WROOM-02-H4 | WiFi-Module 802.112, 4GHz 150Mb/s | U10 | 1 Espressif Systems | ESP32-C3-WROOM-02-H4 | | DigiKey | 1965-ESP32-C3-WROOM-02-H4CT-ND | 3.62 | 3.62

SEEEDUINO | SAMD21 Microcontroller Development Board 0.0327MHz/48MH zCPU32KBRAM 256KBFlash | U11 | 1 SeeedStudio | 102010328 | | DigiKey | 1597-102010328-ND | | 5.4 | 5.4

ABM11-20.000MHZ-D2X-T3 | Crystal 20MHz ±20ppm(Tol) ±20ppm(Stability) 10pFFUND 120Ohm4-Pin UltraMini-CSMD T/R | Y1 | 1 | | | Digikey | 815-ABM11-20-D2XT3

ABS07-32.768KHZ-T | Crystal 0.032768MHz ±20ppm(Tol) 12.5pFFlexural 70000Ohm2-Pin CSMDT/R | Y2 | 1 Abracon | ABS07-32.768KHZ-T | VolumeProduction | DigiKey | 535-9542-1-ND | 0.61 | 0.61
