sauce-an/tp2_pm/Core/Src/main.c

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
/* Includes ------------------------------------------------------------------*/
#include "main.h"
#include "fatfs.h"

/* USER CODE BEGIN Includes */

#include "lcd_new.h"
#include "menu.h"
#include "comm.h"
#include "connect.h"
#include "brightness.h"
#include "wifi.h"
#include "DC_meas.h"
#include "AC_meas.h"
#include "sd_comm.h"
#include <stdlib.h>
#include <math.h>

/* USER CODE END Includes */

/* USER CODE BEGIN PM */

LCD_Handle_t main_lcd;

/* USER CODE END PM */

ADC_HandleTypeDef hadc1;
ADC_HandleTypeDef hadc2;
ADC_HandleTypeDef hadc3;
DMA_HandleTypeDef hdma_adc3;

RTC_HandleTypeDef hrtc;

SPI_HandleTypeDef hspi2;
SPI_HandleTypeDef hspi3;
DMA_HandleTypeDef hdma_spi3_tx;

TIM_HandleTypeDef htim1;

UART_HandleTypeDef huart1;
UART_HandleTypeDef huart3;
DMA_HandleTypeDef hdma_usart1_rx;

/* USER CODE BEGIN PV */
int measurement_no = 1;
extern uint8_t rtc_just_synced;

/* USER CODE END PV */

void SystemClock_Config(void);
void PeriphCommonClock_Config(void);
static void MX_GPIO_Init(void);
static void MX_DMA_Init(void);
static void MX_RTC_Init(void);
static void MX_USART3_UART_Init(void);
static void MX_TIM1_Init(void);
static void MX_USART1_UART_Init(void);
static void MX_ADC2_Init(void);
static void MX_ADC1_Init(void);
static void MX_ADC3_Init(void);
static void MX_SPI3_Init(void);
static void MX_SPI2_Init(void);
/**
  * @brief  The application entry point.
  * @retval int
  */
int main(void)
{

  /* MCU Configuration--------------------------------------------------------*/

  /* Reset of all peripherals, Initializes the Flash interface and the Systick. */
  HAL_Init();

  /* Configure the system clock */
  SystemClock_Config();

  /* Configure the peripherals common clocks */
  PeriphCommonClock_Config();

  /* Initialize all configured peripherals */
  MX_GPIO_Init();
  MX_DMA_Init();
  MX_RTC_Init();
  MX_TIM1_Init();
  MX_USART1_UART_Init();
  MX_ADC2_Init();
  MX_ADC1_Init();
  MX_ADC3_Init();
  MX_SPI3_Init();
  MX_SPI2_Init();
  MX_FATFS_Init();
  /* USER CODE BEGIN 2 */

  HAL_PWREx_EnableBatteryCharging(PWR_BATTERY_CHARGING_RESISTOR_1_5); // Super cap charging (1.5k)

  LCD_Init(&main_lcd, &hspi3, GPIOD, GPIO_PIN_2); // new hspi3 and PD2 (LCD_SELECT)

  // Initialize the new PWM backlight driver using Timer 1
  extern TIM_HandleTypeDef htim1;
  Brightness_Init(&htim1);

  extern ADC_HandleTypeDef hadc2; // All DC
  extern ADC_HandleTypeDef hadc1; // AC Current
  extern ADC_HandleTypeDef hadc3; // AC Voltage
  DC_Meas_Init(&hadc2);
  AC_Meas_Init();

  Menu_Init();
  Connect_Init();
  Comm_Init();

  HAL_Delay(1000); // time for WiFi boot
  Wifi_CreateConnection();

  uint32_t lastCalcTime = 0;

  // SD parameters
  uint8_t toggle_sd = 1;
  uint8_t last_toggle_sd = 1;


  /* USER CODE END 2 */

  /* Infinite loop */
  /* USER CODE BEGIN WHILE */
  while (1)
  {

	  //Connect_Update();

	  // SD
	  toggle_sd = HAL_GPIO_ReadPin(GPIOC, GPIO_PIN_8);
	  if (toggle_sd == 0 && last_toggle_sd == 1) { // handle status of sd logging
	            HAL_Delay(10);
	            if(HAL_GPIO_ReadPin(GPIOC, GPIO_PIN_8) == 0) {
	                SD_toggle_logging();
	            }
	  }
	  last_toggle_sd = HAL_GPIO_ReadPin(GPIOC, GPIO_PIN_8);


	  // sampling loop
	  if ((HAL_GetTick() - lastCalcTime >= 1000) || rtc_just_synced == 1) {


		  if (rtc_just_synced == 1) {
			  rtc_just_synced = 0; // reset
		  } else {lastCalcTime += 1000;}

		  //Safe_UART_Restore();

		  //Connect_Update();
		  DC_Meas_Update(&hadc2);
		  //Blink_Measurement_LED();
		  AC_Meas_Update(&hadc3, &hadc1);
		  //Blink_Measurement_LED();
		  SD_log_measurement();

	      //Generate_Fake_Data();
	  	  //Comm_SendTelemetry(); // send to pc every 1 sec
	  	  //Wifi_SendTelemetry(); // send data to PC through Wi-Fi

	      // --- DATA ROUTER & COMS MODE ICON ---
	      if (Menu_GetDataMode() == MODE_WIFI || Connect_GetMode() == CONN_WIFI) {

	    	  Wifi_SendTelemetry(); // User forced WiFi

	      } else if (Menu_GetDataMode() == MODE_USB) {

	    	  Safe_UART_Restore();
	    	  Comm_SendTelemetry();

	    	  __HAL_UART_DISABLE(&huart3);
	    	  HAL_UART_DeInit(&huart3);

	  	  	  GPIO_InitTypeDef GPIO_InitStruct = {0};
	    	  GPIO_InitStruct.Pin = GPIO_PIN_10 | GPIO_PIN_11;
	    	  GPIO_InitStruct.Mode = GPIO_MODE_ANALOG;
	    	  GPIO_InitStruct.Pull = GPIO_PULLDOWN;
	    	  HAL_GPIO_Init(GPIOB, &GPIO_InitStruct);
	    	  HAL_GPIO_WritePin(GPIOB, GPIO_PIN_11, GPIO_PIN_RESET);

	    	  // If Connect_GetMode returns CONN_NONE, the STM32 safely idles and transmits nothing
	      }

	  	  Draw_Screen();
	  }

	  // update the FSM and screen
	  Menu_Update();
    /* USER CODE END WHILE */

    /* USER CODE BEGIN 3 */
  }
  /* USER CODE END 3 */
}

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
/* USER CODE BEGIN 4 */

// --- DMA COMPLETE INTERRUPT ---
// --- DMA COMPLETE INTERRUPT ---
void HAL_SPI_TxCpltCallback(SPI_HandleTypeDef *hspi) {
    if (hspi->Instance == SPI3) {
        // FIX: Must be SET (High) to release the LCD and ignore background noise
        HAL_GPIO_WritePin(main_lcd.cs_port, main_lcd.cs_pin, GPIO_PIN_SET);
        main_lcd.is_dma_busy = 0;
    }
}

/* USER CODE END 4 */
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
