sauce-an/tp2_pm/Core/Inc/main.h

#define AC_HIGH_CURRENT_MEAS_Pin GPIO_PIN_0
#define AC_HIGH_CURRENT_MEAS_GPIO_Port GPIOC
#define AC_LOW_CURRENT_MEAS_Pin GPIO_PIN_1
#define AC_LOW_CURRENT_MEAS_GPIO_Port GPIOC
#define RANGE_SELECT_Pin GPIO_PIN_2
#define RANGE_SELECT_GPIO_Port GPIOC
#define AC_VOLTAGE_Pin GPIO_PIN_3
#define AC_VOLTAGE_GPIO_Port GPIOC
#define DC_VOLTAGE_Pin GPIO_PIN_0
#define DC_VOLTAGE_GPIO_Port GPIOA
#define DC_CURRENT_Pin GPIO_PIN_1
#define DC_CURRENT_GPIO_Port GPIOA
#define SD_CARD_SELECT_Pin GPIO_PIN_12
#define SD_CARD_SELECT_GPIO_Port GPIOB
#define LCD_RESET_Pin GPIO_PIN_6
#define LCD_RESET_GPIO_Port GPIOC
#define LCD_SELECT_Pin GPIO_PIN_2
#define LCD_SELECT_GPIO_Port GPIOD
#define SD_SPI_HANDLE hspi2
