sauce-an/tp2_pm/Core/Inc/wifi.h

/*
 * wifi.h
 *
 *  Created on: Mar 30, 2026
 *  Author: Lauren Moffatt
 */

#ifndef INC_WIFI_H_
#define INC_WIFI_H_

/* Functions */
void Wifi_CreateConnection(void);
void Wifi_SendTelemetry(void);
void Wifi_CloseConnection(void);

#endif /* INC_WIFI_H_ */
