sauce-an/tp2_pm/(commit log)

2026-08-20 Initial commit: Smart AC/DC Power Measurement firmware with README
2026-08-20 Add hardware schematics, specifications, and update MCU to STM32L476RET6TR
